sauravguptadx/4-Bit-PC-Proteus/4-Bit PC/Report Document.pdf

Bangladesh University of Engineering and Technology

Course No: CSE 404

Course Title: Digital System Design Sessional

A Report on 4-bit PC

Date of Submission: August 4, 2018

Submitted By:

Tahrina Tasnim Misha (1405100)

Nahiyaan Uddin (1405102)

Salsabil Arabi Shushmi (1405108)

Mirajul Islam (1405119)

Rajan Shrestha (1405121)

Saurav Gupta (1405122)

Introduction:
For 4-bit pc assignment we have to implement 25 instructions. According to our 25 instructions the 4-bit PC has
-In Port
-Program Counter(PC),
-Memory address register(MAR)
- Memory
- Memory Data Register(MDR)
- Instruction Register(IR) -Controller sequencer(CON)
- Accumulator(ACC)
- Arithmetic logic unit(ALU) -Flag
-Temp reg
-B reg
-Stack pointer(SP)
-Output reg(OUT)
-Display

The Address bus is of 8-bit
The Data is 4-bit
We need several clock cycles and maximum 11 T-cycles for an instruction. We need 40 signal pins on a whole.

Instruction set:

Instruction | Description
1. STA address | Memory[address] ← Acc
2. MOV Acc, B | Acc ← B
3. MOV B, Acc | B ← Acc
4. ADC B | Acc ← Acc + B + Carry
5. SUB B | Acc ← Acc - B
6. SBB address | Acc ← Acc - Memory[address] - Carry
7. SBB Immediate Acc ← Acc - Immediate - Carry
8. IN | Acc ← Input_port
9. OUT | Output _port ← Acc
10. PUSH | Pushes the content of the Accumulator to the Stack
11. POP | Pops off top element of stack to Accumulator
12. AND B | Acc ← Acc.B
13. OR address | Acc ← Acc | Memory[address]
14. OR Immediate Acc ← Acc | Immediate
15. XOR address | Acc ← Acc Memory[address]
16. CMP B | Accumulator will be unchanged. Set flags according to ( Acc - B )
17. SHL | Acc ← Acc << 1, Carry ← Acc [MSB], Acc [LSB] ← 0
18. ROR | Acc ← Acc >> 1, Carry ← Acc [LSB], Acc [MSB] ← Acc [LSB]
19. JMP address | Jumps to the address
20. JNC address | Jumps to the address if Carry flag is not set
21. JG address | Jump if greater
22. JL address | Jump if less
23. CMC | Complements the Carry flag
24. CLC | Clears the Carry flag
25. HLT | Halts execution

Block Diagram:

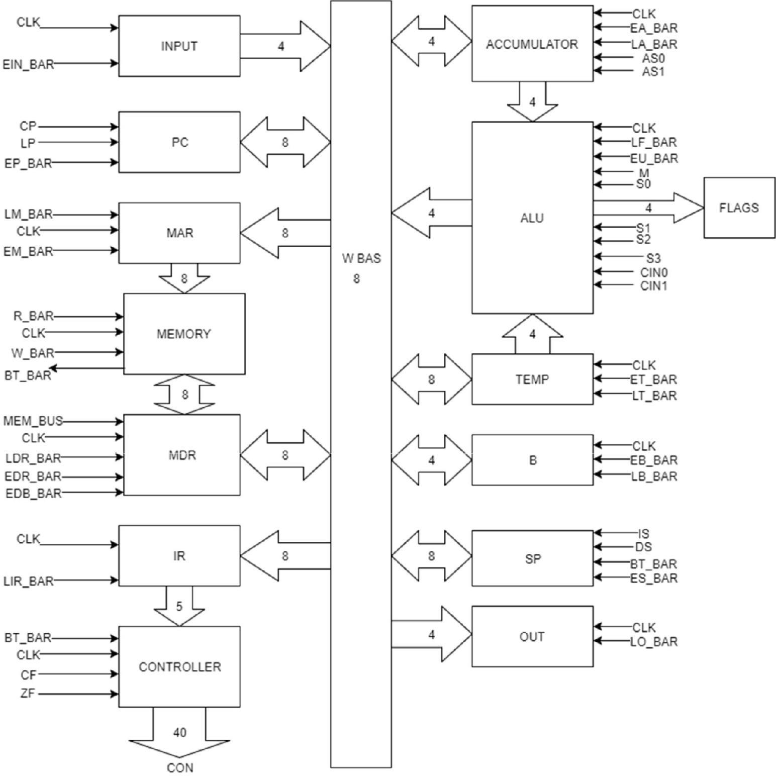
[picture p1: figure]

Fig: block diagram of 4-bit PC

## Explanation of Blocks:

Input Register:

-Control Pin: E_IN

-4 bit register
-Used to take input from user and then store it in a buffer.
-When E_IN becomes high, the output of this register is sent to bus (W0-W3).

Program Counter:

-Control Pin: CP, L_PC, E_PC

-8 bit register
-Contains the address pointer value of the current instruction.
-After each instruction cycle it points to the next instruction in memory.
-For jump we need to load address to PC. This is also done by interacting with bus (W0-W7).
- The L_PC control pin is used to load the address of the instruction to PC.
- PC register passes its output to the bus, when E_PC is high.
-CP control pin is used to increment the PC to fetch the next instruction.

Memory Address Register:

-Control Pin: L_Mem

-8-bit register
-It takes 8-bit address as input from PC
-When L_Mem is high, address is loaded to MAR through W-bus.

9

Memory:

-Control Pin: W, R
Memory has two parts: RAM and Boot Loader.

RAM:

-RAM has following input lines, Mem0-Mem7, these lines connect RAM and MAR. These lines are used to provide address to RAM. And, bidirectional data line, RM0-RM7 -These lines connect MDR and RAM, using these lines either data is fed into RAM using the W signal, or Data is read from RAM using the R signal.

-To write content to RAM at a particular address, we must point at the interested address of RAM using MAR, we provide data in RM0-RM7 lines via MDR, then we control W signal to write the data.
-To read content from RAM at a particular address, we point that address using MAR, then we control the R signal to read content from RAM, later on this data is sent to MDR.

Boot loader:

-Boot loader resides inside the MEMORY module. It is responsible for loading program data from a ROM to RAM during boot period.
-Boot loader is consisted of two ROMs, and two counters. One of the ROMs contains the instructions and data and a special sentinel value FF, which is used to terminate the boot-loading process.
-The second ROM contains control words to drive the boot-loading process.
-Using one counter, we provide same address to both the program ROM and RAM, so that content in ROM at a particular address can be sent to that exact address in RAM. -Using the second counter, we drive the boot control ROM.

10

Memory Data Register:

The Control Pin: L_MDR_RAM, L_MDR_BUS, E_MDR _RAM, E_MDR _BUS.

-8-bit register
- RM0-RM7 is used to read from or write into memory through data line.
-When L_MDR_RAM is HIGH, data is loaded to MDR from RAM. This is used to read data from RAM.
-When L_MDR_BUS is HIGH, data is loaded to MDR from the BUS.
-When E_MDR_BUS is HIGH, data from the MDR is sent to BUS via W0-W7. -When E_MDR _RAM is HIGH, data from the MDR is sent to RAM via RM0-RM7.

Instruction Register:

Control Pin: L_IR

-When L_IR is HIGH, IR can load content from MDR via W0-W7 line.
-Instruction Register is an 8-bit register.
-During Fetch cycle, IR is loaded with 8-bit op-code of an instruction through W-bus (W0-W7 line) from MDR. Our 4-bit PC can execute 25 Instructions, so we only need 5 bits. IR register then sends the least significant 5 bits of the op-code to Control register using the CON0-C0N4 line.

Controller-Sequencer:

Generates the control word for each micro instructions. It has two kinds of ROMs. They are:
1. Address ROM
2. Control ROMs

-The address ROM contains a list of starting address of the execution cycle of each macro instructions.
-We need only 5 bits because our 4-bit PC can execute 25 macro-instruction, so we need only 5 bits (2^5=32) to index all the macro instructions.
-According to these 5 op-code bits, starting address of the execution cycle of a particular micro instruction is generated.
-Our control ROMs consist of five cascading ROMs, because our control word is 40-bit length. The outputs of these ROMs are our control word for a particular micro instruction.
-The zero index refers to the first microinstruction of fetch cycle and corresponding control word is generated by the control ROMs.

-The control word for second, third and fourth micro instructions of fetch cycle are generated in the same way.
-When LOAD signal is active, our address ROM loads op-code from Instruction Register. On the next clock cycle, the counter starts counting from the address generated by address ROM which refers to the index first micro instruction of the execution cycle of that macro operation.
-We need to mark the end of a macro instruction. At the last micro instruction of each macro operation, we set a special RESET signal to 1. When this RESET signal is active, the counter resets to 0 which refers to the index of the first micro instruction of fetch cycle and the process continues.

Accumulator Register:

Control Pin: E_ACC, L_ACC, AS0, AS1

-4-bit register that can load data from bus or send data to bus using W0-W3 line. It also passes data to Arithmetic Logic Unit (ALU) through A0-A3 line to perform different arithmetic and logic operations.
-When E_ACC is HIGH, the data of Accumulator register is sent to W-bus.
-When L_ACC is low, Accumulator register loads data from W-bus.
-AS0 and AS1 are used to shift the content of Accumulator register.
-When both AS0 and AS1 are high, Accumulator contents are unchanged. This is why we need to set these two control pins every time we need to load data into accumulator. -When AS0 is high and AS1 is low, Accumulator contents are shifted right.
- When AS0 is low and AS1 is high, Accumulator contents are shifted left.
-CACC is used to store the CARRY.

Arithmetic Logic Unit:

Control Pin: L_FLAG, E_ALU, M, S0, S1, S2, S3, CIN0, CIN1

ALU takes data from Accumulator register through A0-A3 line and from Temp Register through T0-T3 line and performs various arithmetic and logic operations.

ALU uses five control bits M, S0, S1, S2 and S3 to do various operations on word A and word B.
Data inputs for ALU come from Accumulator register (ACC) and Temp register (TEMP).

The function table is given in the next page.

-Arithmetic operations like ADD, ADC, SUB, SBB require us to put different values in CN bit of the ALU.
-In an ADD operation, we need to put 0 in CN pin.
-In an ADC operation, we need to put carry flag in CN pin.
-In a SUB operation we need to put 1 in CN.
-In a SBB operation we need to put the invert of carry flag in CN pin.
-To ensure these, we introduce two pins CIN0 and CIN1 to control the content of CN bit of ALU.

The combination is given below:

CIN1 | CIN0 | CN | Operation
0 | 0 | 0 | ADD
0 | 1 | Carry Flag (CF) | ADC
1 | 0 | 1 | SUB
1 | 1 | Invert of Carry Flag (CF_BAR) | SBB

-We store the carry flag (CF), zero flag (ZF), sign flag (SF) and overflow flag (OF) in a register.
-Carry, sign and zero flag can be found from ALU.
-For overflow flag (OF) we use a simple logic which is, when two positive numbers are added and the result is negative or when two negative numbers are added and the result is positive, overflow occurs.

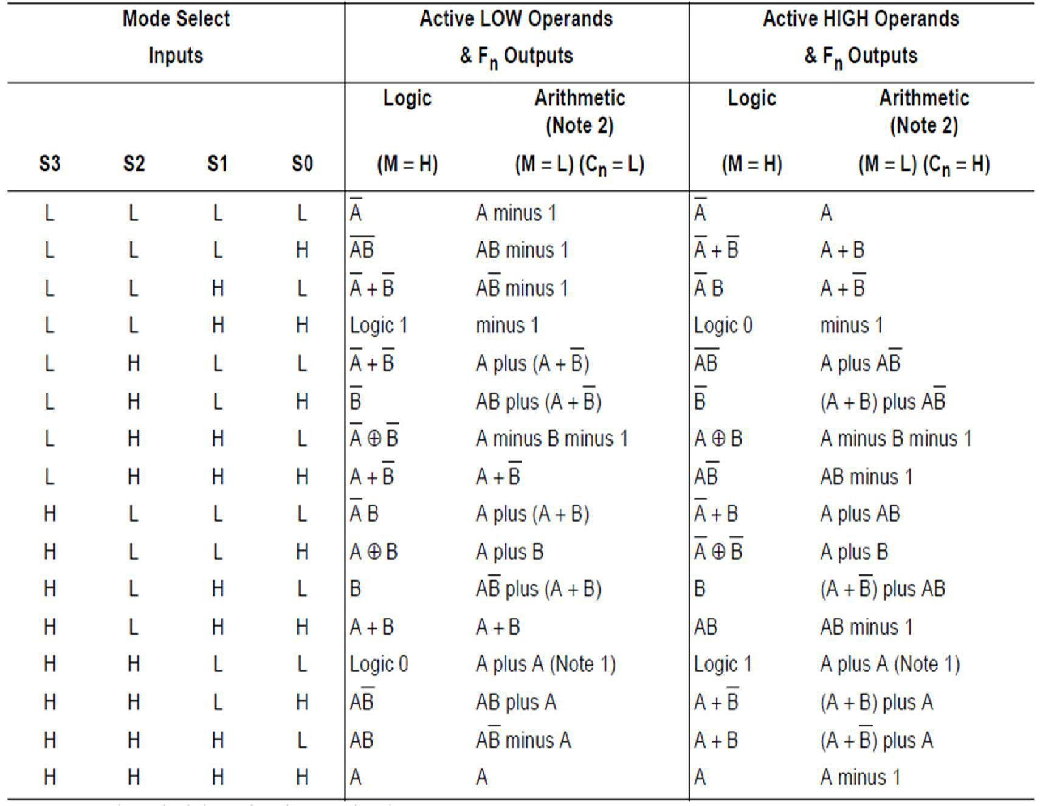
[picture p2: figure]

Temporary Register:

Control Pin: L_TEMP

-8-bit register to store 4-bit data for our instructions
-This register can load data from W-bus using W0-W3 line.
-It sends data to Arithmetic Logic Unit (ALU) through T0-T3 line continuously to perform different arithmetic and logic operations.
-When L_TEMP is HIGH, Temp register loads data from W-bus.

B Register:

Associated Control Pin: L_B, E_B

- 4-bit register that can load data from W-bus or send data to W-bus using W0-W3 line. -When E_B is HIGH, the data of B register is sent to W-bus.
-When L_B is HIGH, B register loads data from W-bus.

Stack Pointer:

Control Pin: E_SP, INC_SP, DEC_SP

-It is an 8-bit register that stores the address of the last program request in a stack. -Initially, the Stack Pointer points to FF-the last memory location.
-For push operation, SP is first decremented and then loaded to MAR so that data can be written in that location.
-If a POP operation is done, SP is loaded to MAR so that data in that address can be read and after that value of SP is incremented.

-When E_SP is HIGH, the contents of Stack Pointer (SP) is sent to bus through W0-W7 line.
-When INC_SP is HIGH, the value of SP is incremented.
-When DEC_SP is HIGH, the value of SP is decremented.

Output Register:

-Control Pin: L_OUT

-It is 4-bit register that can load data from W-bus through W0-W3 line to show the result of different operations.

When L_OUT is HIGH, OUT register loads data from W-bus.

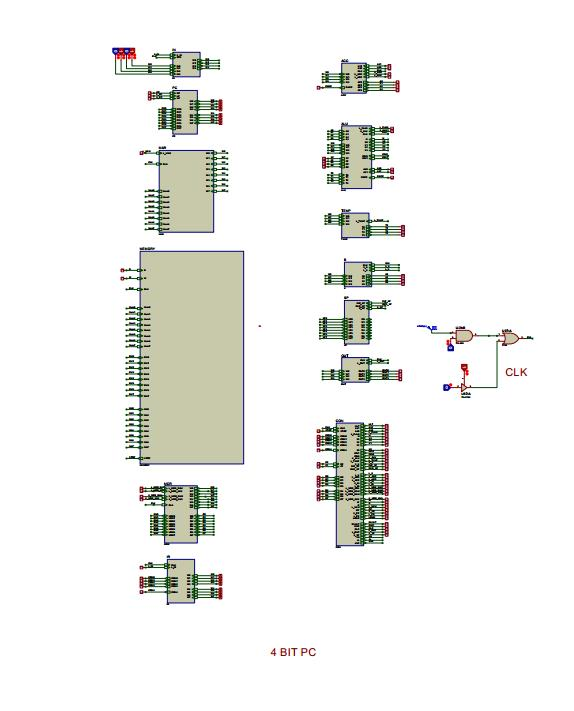
[picture p3: page 12]

Circuit Diagrams:

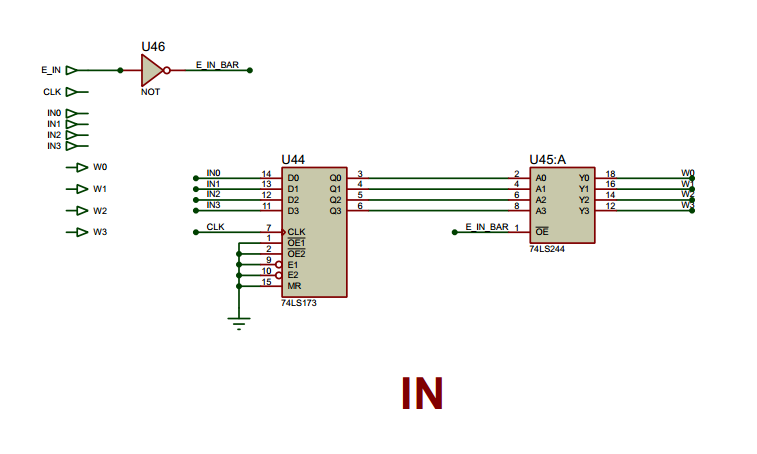
[picture p4: figure]

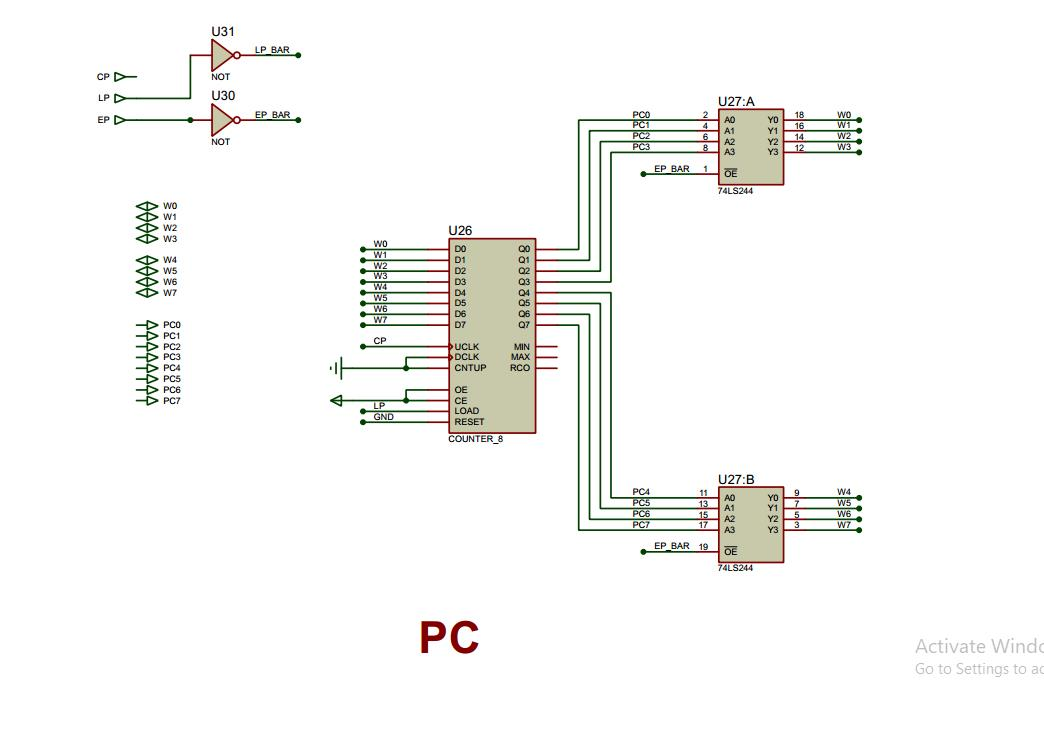
[picture p5: figure]

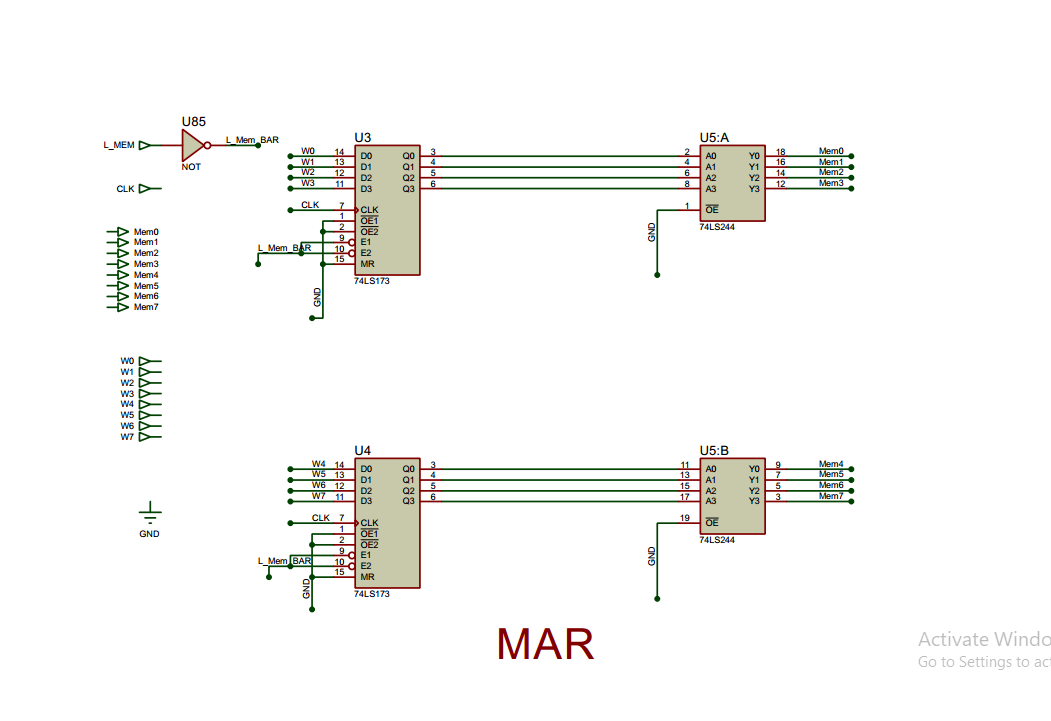
[picture p6: figure]

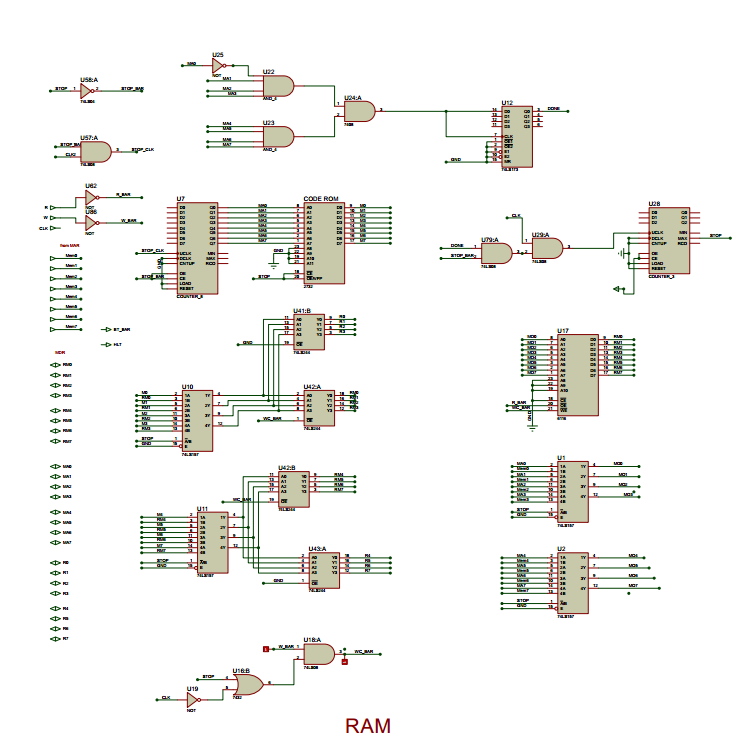
[picture p7: figure]

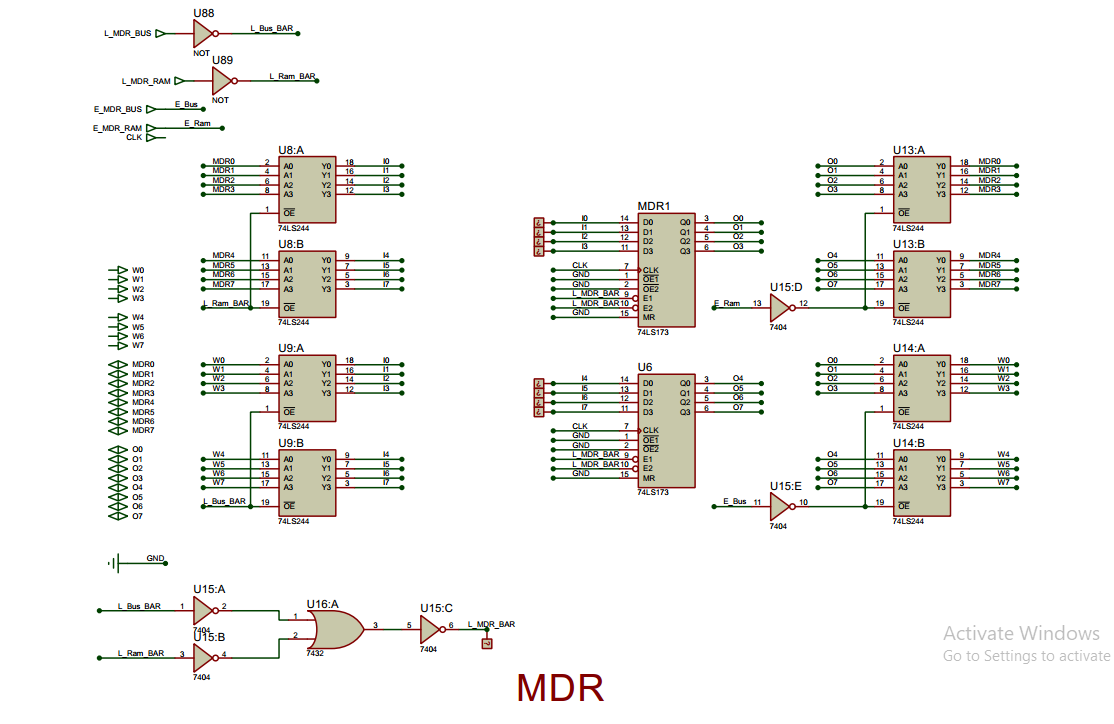
[picture p8: figure]

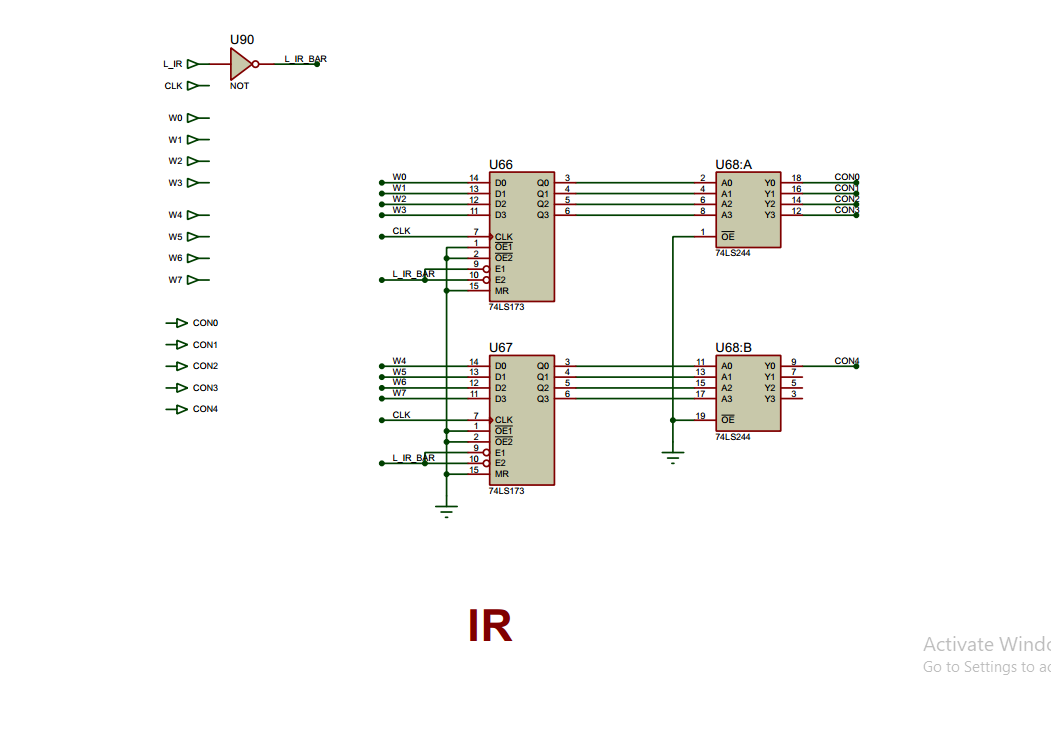
[picture p9: figure]

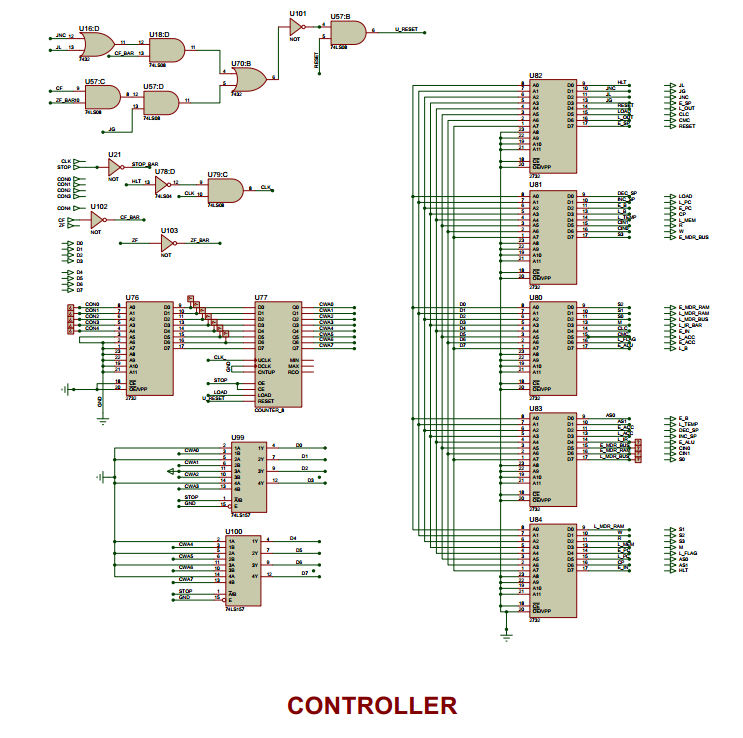
[picture p10: figure]

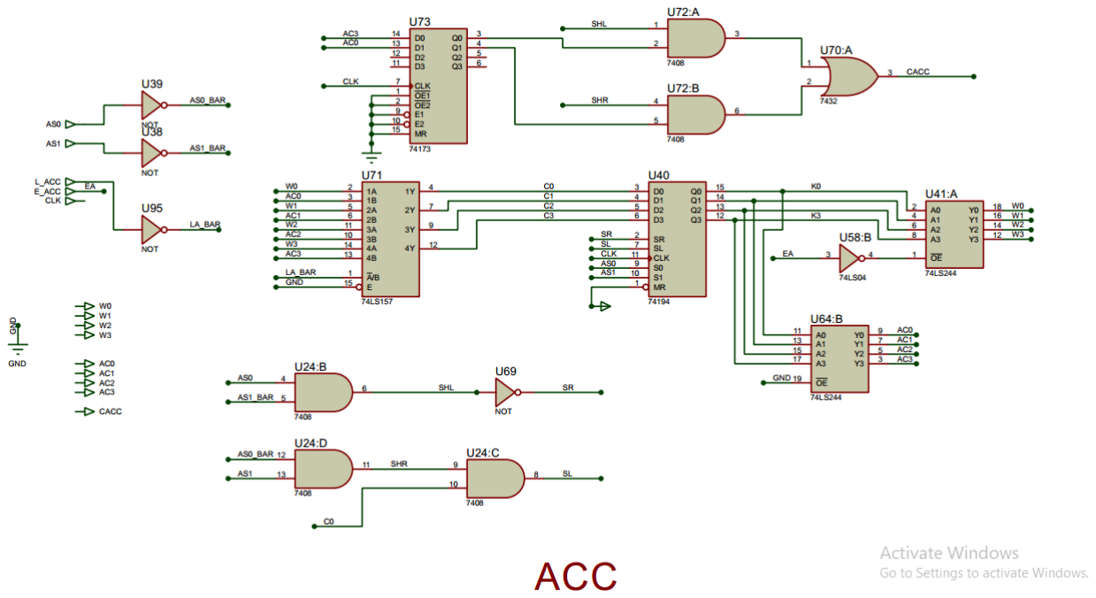
[picture p11: figure]

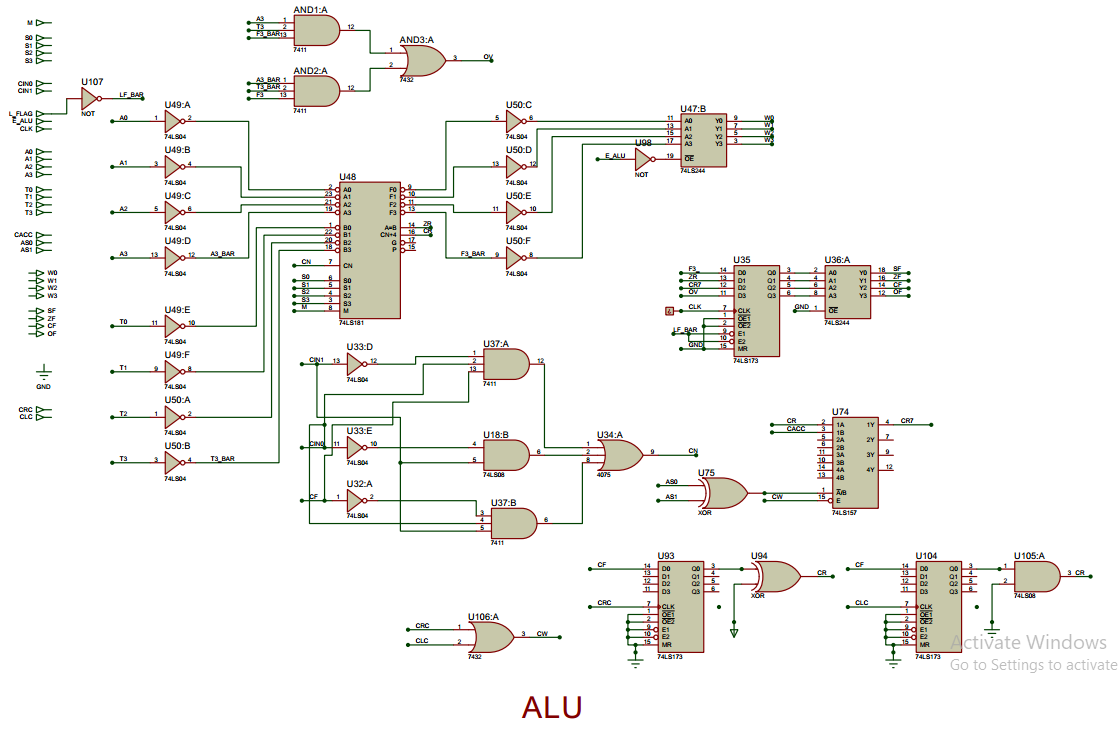
[picture p12: figure]

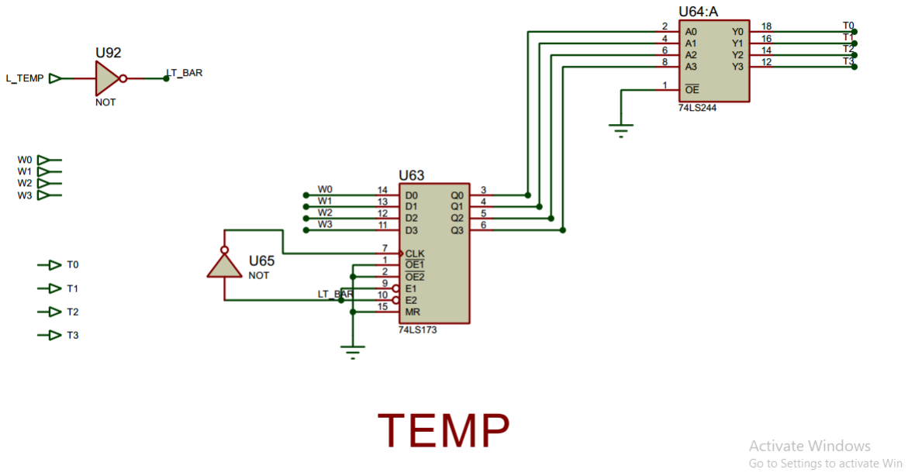
[picture p13: figure]

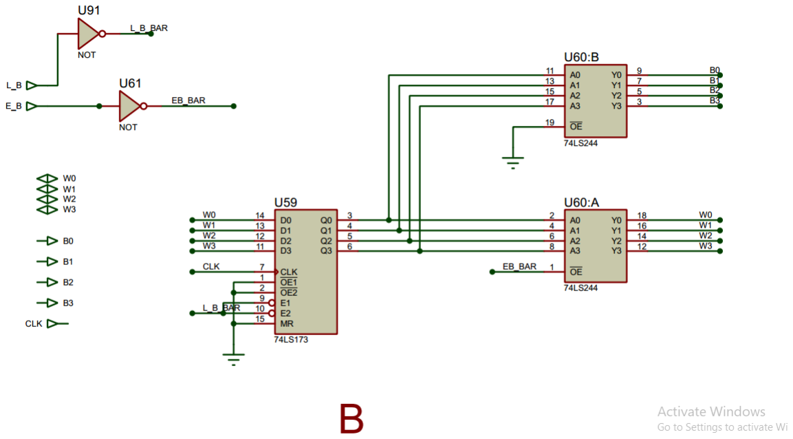
[picture p14: figure]

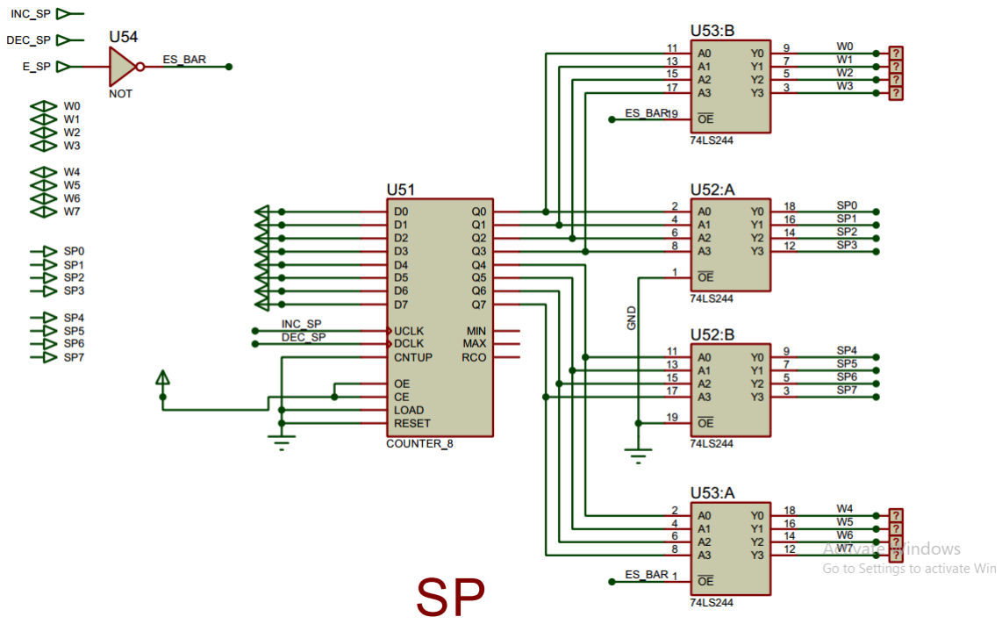
[picture p15: figure]

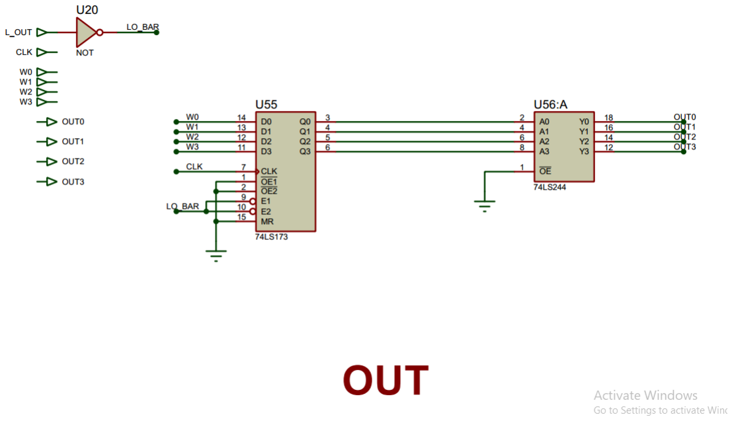
[picture p16: figure]

Explanation of all instructions:

Description | Total T-States | T-State | Micro-Operation | Active | CR O M 0 | CR O M 1 | CR O M 2 | CR O M3 | CR O M 4
Fetch | 4 | T1 | MAR ← PC | L_MEM, E_PC | 10 | 18 | ff | df | 0
| | T2 | PC← PC+1, MDR ← RAM[MAR] | CP, L_MDR_RAM, R, | 10 | 18 | ff | ce | 98
| | T3 | IR ← MDR | E_MDR_BUS, L_IR | 10 | 18 | ff | 9b | c8
| | T4 | LOAD from IR | LOAD | 10 | 18 | ff | df | ca
ACC ← RAM[address] | 9 | T5 | MAR ← PC | L_MEM, E_PC | 10 | 18 | ff | df | 0
| | T6 | PC← PC+1, MDR ← RAM[MAR] | CP, L_MDR_RAM, R | 10 | 18 | ff | ce | 98
| | T7 | MAR ← MDR | L_MEM, E_MDR_BUS, | 10 | 18 | ff | db | 8
| | T8 | MDR ← RAM[MAR] | L_MDR_RAM, R | 10 | 18 | ff | ce | 88
| | T9 | ACC ← MDR | L_ACC, E_MDR_BUS, AS0, AS1, RESET | 70 | 18 | fe | db | c9
Halts execution | 5 | T5 | HALT | HLT | 90 | 18 | ff | df | c8
ACC ← input_port | 5 | T5 | ACC ← input_port | L_ACC, AS0, AS1, E_IN, RESET | 70 | 18 | fe | 5f | c9
RAM[address] ← ACC | 12 | T5 | MAR ← PC | L_MEM, E_PC | 10 | 18 | ff | df | 0
| | T6 | PC← PC+1, MDR ← RAM[MAR] | CP, L_MDR_RAM, R | 10 | 18 | ff | ce | 98
| | T7 | MAR ← MDR | L_MEM, E_MDR_BUS, | 10 | 18 | ff | db | 8
| | T8 | MDR ← ACC | L_MDR_RAM, E_ACC, E_MDR_BUS, | 10 | 18 | fd | ef | 88
| | T9 | RAM[MAR] ← MDR | E_MDR_RAM, | 10 | 18 | ff | d7 | 88
| | T10 | | W, E_MDR_RAM, | 10 | 18 | ff | d5 | 88
| | T11 | | E_MDR_RAM, | 10 | 18 | ff | d7 | 88
| | T12 | | R, RESET, | 10 | 18 | ff | de | 89
output_port ← ACC | 5 | T5 | output_port ← ACC | L_OUT, E_ACC, RESET | 10 | 18 | ed | df | c9
B ← ACC | 5 | T5 | B ← ACC | L_B, E_ACC, RESET | 10 | 18 | f9 | df | c9
ACC ← B | 5 | T5 | ACC ← B | L_ACC, AS0, AS1, E_B, RESET | 70 | 18 | f6 | df | c9
ACC ← immediate | 7 | T5 | MAR ← PC | L_MEM, E_PC, | 10 | 18 | ff | df | 0
| | T6 | PC← PC+1, MDR ← RAM[MAR] | CP, L_MDR_RAM, R, | 10 | 18 | ff | ce | 98
| | T7 | ACC ← MDR | L_ACC, AS0, AS1, E_MDR_BUS, RESET | 70 | 18 | fe | db | c9
NOP | 5 | T5 | NOP | RESET | 10 | 18 | ff | df | c9
Jump to the address | 8 | T5 | MAR ← PC | L_MEM, E_PC, | 10 | 18 | ff | df | 0
| | T6 | PC← PC+1, MDR ← RAM[MAR] | CP, L_MDR_RAM, R, | 10 | 18 | ff | ce | 98
| | T7 | PC ← MDR | LP, E_MDR_BUS | 10 | 18 | ff | db | cc
T8 | | CP, LP, RESET | 10 | 18 | ff | df | dd
ACC ← ACC + B | 7 | T5 | TEMP ← B | L_TEMP, E_B, S3, S0 | 14 | 98 | b7 | df | c8
| | T6 | ACC ← ACC + TEMP | S3, S0 | 14 | 98 | ff | df | c8

| | T7 | | L_ACC, AS0, AS1, E_ALU, S3, S0, L_FLAG, RESET | 64 | 90 | fe | df | c9
ACC ← ACC + B + C | 7 | T5 | TEMP ← B | L_TEMP, E_B, S3, S0, CIN0 | 14 | b8 | b7 | df | c8
| | T6 | ACC ← ACC + TEMP + C | S3, S0, CIN0 | 14 | b8 | ff | df | c8
| | T7 | | L_ACC, AS0, AS1, E_ALU, S3, S0, CIN0, L_FLAG, RESET | 64 | b0 | fe | df | c9
ACC ← ACC -B | 7 | T5 | TEMP ← B | L_TEMP, E_B, S2, S1, CIN1 | 13 | 58 | b7 | df | c8
| | T6 | ACC ← ACC - TEMP | S2, S1, CIN1 | 13 | 58 | ff | df | c8
| | T7 | | L_ACC, AS0, AS1, E_ALU, S2, S1, CIN1, L_FLAG, RESET | 63 | 50 | fe | df | c9
ACC ← ACC - B - BO | 7 | T5 | TEMP ← B | L_TEMP, E_B, S2, S1, CIN1, CIN0 | 13 | 78 | b7 | df | c8
| | T6 | ACC ← ACC - TEMP - BO | S2, S1, CIN1, CIN0 | 13 | 78 | ff | df | c8
| | T7 | | L_ACC, AS0, AS1, E_ALU, S2, S1, CIN1, CIN0, L_FLAG, RESET | 63 | 70 | fe | df | c9
ACC ← ACC + immediate | 9 | T5 | MAR ← PC | L_MEM, E_PC, | 10 | 18 | ff | df | 0
| | T6 | PC← PC+1, MDR ← RAM[MAR] | CP, L_MDR_RAM, R, | 10 | 18 | ff | ce | 98
| | T7 | TEMP ← MDR | L_TEMP, E_MDR_BUS, S3, S0 | 14 | 98 | bf | db | c8
| | T8 | ACC ← ACC + TEMP | S3, S0 | 14 | 98 | ff | df | c8
| | T9 | | L_ACC, AS0, AS1, E_ALU, S3, S0, L_FLAG, RESET | 64 | 90 | fe | df | c9
ACC ← ACC -RAM[address] | 11 | T5 | MAR ← PC | L_MEM, E_PC, | 10 | 18 | ff | df | 0
| | T6 | PC← PC+1, MDR ← RAM[MAR] | CP, L_MDR_RAM, R, | 10 | 18 | ff | ce | 98
| | T7 | MAR ← MDR | L_MEM, E_MDR_BUS, | 10 | 18 | ff | db | 8
| | T8 | MDR ← RAM[MAR] | L_MDR_RAM, R, | 10 | 18 | ff | ce | 88
| | T9 | TEMP ← MDR | L_TEMP, E_MDR_BUS, S2, S1, CIN1 | 13 | 58 | bf | db | c8
| | T10 | ACC ← ACC - TEMP | S2, S1, CIN1 | 13 | 58 | ff | df | c8
| | T11 | | L_ACC, AS0, AS1, E_ALU, S2, S1, CIN1, L_FLAG, RESET | 63 | 50 | fe | df | c9
ACC -B | 7 | T5 | TEMP ← B | L_TEMP, E_B, S2, S1, CIN1 | 13 | 58 | b7 | df | c8
| | T6 | ACC - TEMP | S2, S1, CIN1 | 13 | 58 | ff | df | c8
| | T7 | | S2, S1, CIN1, L_FLAG, RESET | 3 | 58 | ff | df | c9
ACC & B | 6 | T5 | TEMP ← B | L_TEMP, E_B | 10 | 18 | b7 | df | c8
| | T6 | ACC & TEMP | L_FLAG, M, S3, S2, S1, RESET | f | 18 | ff | df | c9
ACC ← ACC & B | 6 | T5 | TEMP ← B | L_TEMP, E_B | 10 | 18 | b7 | df | c8
| | T6 | ACC ← ACC & TEMP | L_ACC, AS0, AS1, E_ALU, M, S3, S2, S1, RESET | 7f | 10 | fe | df | c9
ACC ← ACC ⊕ immediate | 8 | T5 | MAR ← PC | L_MEM, E_PC, | 10 | 18 | ff | df | 0
| | T6 | PC← PC+1, MDR ← RAM[MAR] | CP, L_MDR_RAM, R, | 10 | 18 | ff | ce | 98
| | T7 | TEMP ← MDR | L_TEMP, E_MDR_BUS | 10 | 18 | bf | db | c8
| | T8 | ⊕ TEMP ACC ← ACC | L_ACC, AS0, AS1, E_ALU, M, S3, S0, RESET | 7c | 90 | fe | df | c9
RAM[SP] ← ACC | 10 | T5 | SP ← SP - 1, MDR ← ACC | DEC_SP, L_MDR_RAM, E_ACC, E_MDR_BUS, | 10 | 19 | fd | ef | 88
| | T6 | MAR ← SP | L_MEM, E_SP, | 10 | 18 | 7f | df | 8

| | T7 | RAM[MAR] ← MDR | E_MDR_RAM, | 10 | 18 | ff | d7 | 88
| | T8 | | W, E_MDR_RAM, | 10 | 18 | ff | d5 | 88
| | T9 | | E_MDR_RAM, | 10 | 18 | ff | d7 | 88
| | T10 | | R, RESET, | 10 | 18 | ff | de | 89
ACC ← RAM[SP] | 7 | T5 | MAR ← SP | L_MEM, E_SP, | 10 | 18 | 7f | df | 8
| | T6 | MDR ← RAM[MAR] | L_MDR_RAM, R, | 10 | 18 | ff | ce | 88
| | T7 | ACC ← MDR, SP ← SP + 1 | L_ACC, AS0, AS1, E_MDR_BUS, INC_SP, RESET | 70 | 1a | fe | db | c9
ACC ← ACC << 1 | 6 | T5 | ACC ← ACC << 1 | E_ACC | 10 | 18 | fd | df | c8
| | T6 | | L_ACC, AS0, RESET | 50 | 18 | fc | df | c9
ACC ← ACC >> 1 | 6 | T5 | ACC ← ACC >> 1 | E_ACC | 10 | 18 | fd | df | c8
T6 | | L_ACC, AS1, RESET | 30 | 18 | fc | df | c9
Jump if carry | 8 | T5 | MAR ← PC | L_MEM, E_PC, | 10 | 18 | ff | df | 0
| | T6 | PC← PC+1, MDR ← RAM[MAR] | CP, L_MDR_RAM, R, | 10 | 18 | ff | ce | 98
| | T7 | PC ← MDR | LP, E_MDR_BUS | 10 | 18 | ff | db | C c
| | T8 | | CP, LP, RESET | 10 | 18 | ff | df | D d
Jump if equal | 8 | T5 | MAR ← PC | L_MEM, E_PC, | 10 | 18 | ff | df | 0
| | T6 | PC← PC+1, MDR ← RAM[MAR] | CP, L_MDR_RAM, R, | 10 | 18 | ff | ce | 98
| | T7 | PC ← MDR | LP, E_MDR_BUS | 10 | 18 | ff | db | C c
| | T8 | | CP, LP, RESET | 10 | 18 | ff | df | D d

ICs used with count:

IC number | IC name | Number
74LS173 | 4 bit D-type register with 3 state output | 14
74LS244 | Octal 3 state buffer | 18
74LS157 | Quad 2-input Multiplexer | 5
4539 | Dual 4-input Multiplexer | 2
74LS181 | 4 bit Arithmetic Logic Unit | 1
2732 | EPROM 32K (K * 8 bit) | 8
6116 | CMOS Static RAM 16K (2K * 8 bit) | 1
COUNTER_4 | 4 bit binary up/down counter | 1
COUNTER_8 | 8 bit Binary up/down counter | 4
74LS04 | Hex Inverter | 4
74LS32 | Quad 2-input OR gate | 1
74LS08 | Quad 2-input AND gate | 2
7411 | Tri 3-input AND gate | 1
AND_4 | 4-input AND gate | 3
4075 | Tri 3-input OR gate | 1

In total, 66 ICs are used. Many of the 74LS244 (buffer) ICs are used for debugging purpose. So, in the actual circuit the number of this IC would be much less.

How to write and Execute a Program in this computer

Writing:

Writing a program for this computer can be done in two steps,
i) Writing in mnemonics form of instructions.
ii) Converting the mnemonic form to hex code. This is done by merging the hex opcode of the instruction and the hex value of the operand(address or immediate value, if exists)
Each instruction will become a hex value representing 1 or 2 bytes of information, given whether they use address or immediate value operands or not.
Next, we arrange the hex values in a BIN file line by line such that each line has a
two digit hex code( 1 byte).
Each program must be terminated with the HALT instruction which has the hex opcode F.
To denote the end of the program file, we use a special value of FF, we put this
value at the last line of the program BIN file.

A sample program:
LDA 03
MOV B,ACC
05
XOR B
OUT

Here LDA has opcode 00H, MOV B,ACC has opcode 04H, XOR B has opcode 13H, OUT has a opcode 03H.
So in Hex the program file will be:
00
02
05
13
03
We store these hex codes in a BIN file. We add, FF at the final line to denote end of FILE.

Execution:
We load this BIN file in the program ROM. When the PC starts, during the boot loader phase, each of these instructions from the program ROM is loaded into the RAM, afterwards during the fetch cycle, OP is fetched from the RAM and it is eventually sent to the instruction register and the execution phase starts

Discussion:

At first, starting the design was very difficult since we had minimum knowledge about it. Gradually by the passage of time, we could learn from mistakes and the process of designing became easier.
Designing the registers, program counter and stack pointer was easier. But, controller-sequencer and memory were quite difficult in this regards.
We faced problems while designing micro-operations for each instruction. Sometimes, we thought that particular operation could be done in single cycle, but performing them in one cycle resulted in failure. Such as, loading PC from TEMP or MDR took 2 cycles, but initially, we thought this could be done in one cycle. Writing data to an address of RAM requires 3 cycles normally. But when it is the last operation of an instruction, it takes 4 cycles since 3rd cycle of writing to RAM and RESET operation could not be done in a single cycle.
It was very difficult to understand the function of Boot_Loader. After studying more about the process of loading user program into the RAM, it became clear and we
could implement it.
We faced problem in stopping the clock when a HLT instruction is executed. Because, it was interfering with the boot loading process what we did initially. If we corrected the boot loading, then HLT was not stopping the clock. By some trial and error, we could come up with a solution.
Initially, the stack pointer was not getting set to FF rather it was getting
decremented twice and set to FE. This problem was also fixed later on.
For easier debugging, we used lots of buffers in the circuit to see the current value of different components which were not actually needed in the PC circuit.
We also used 7-Segment HEX display for observing the value of control word
and different registers.
We wrote a java code for converting the hex code for the address ROM, control ROM’s into binary file. We provided the active pins for each cycle of an instruction and our program could generate the corresponding control word from it and converted them into a binary file that could be easily used into the simulation circuit.
We also wrote a java program. It could take input a set of instructions (user program) and generate corresponding hex code of that input user program and convert them into a binary file which was loaded into the RAM during boot loading.
At the end, designing a complete PC from scratch had a great influence to all of us. It made us realize how difficult it is to design a multi-purpose PC and helped to clear our concept about so many internal issues of PC designing.

34
