sauravguptadx/4-Bit-PC-Proteus/4-Bit PC/4-BIT-FULL-CIRCUIT.pdf

PC

## ACCUMULATOR

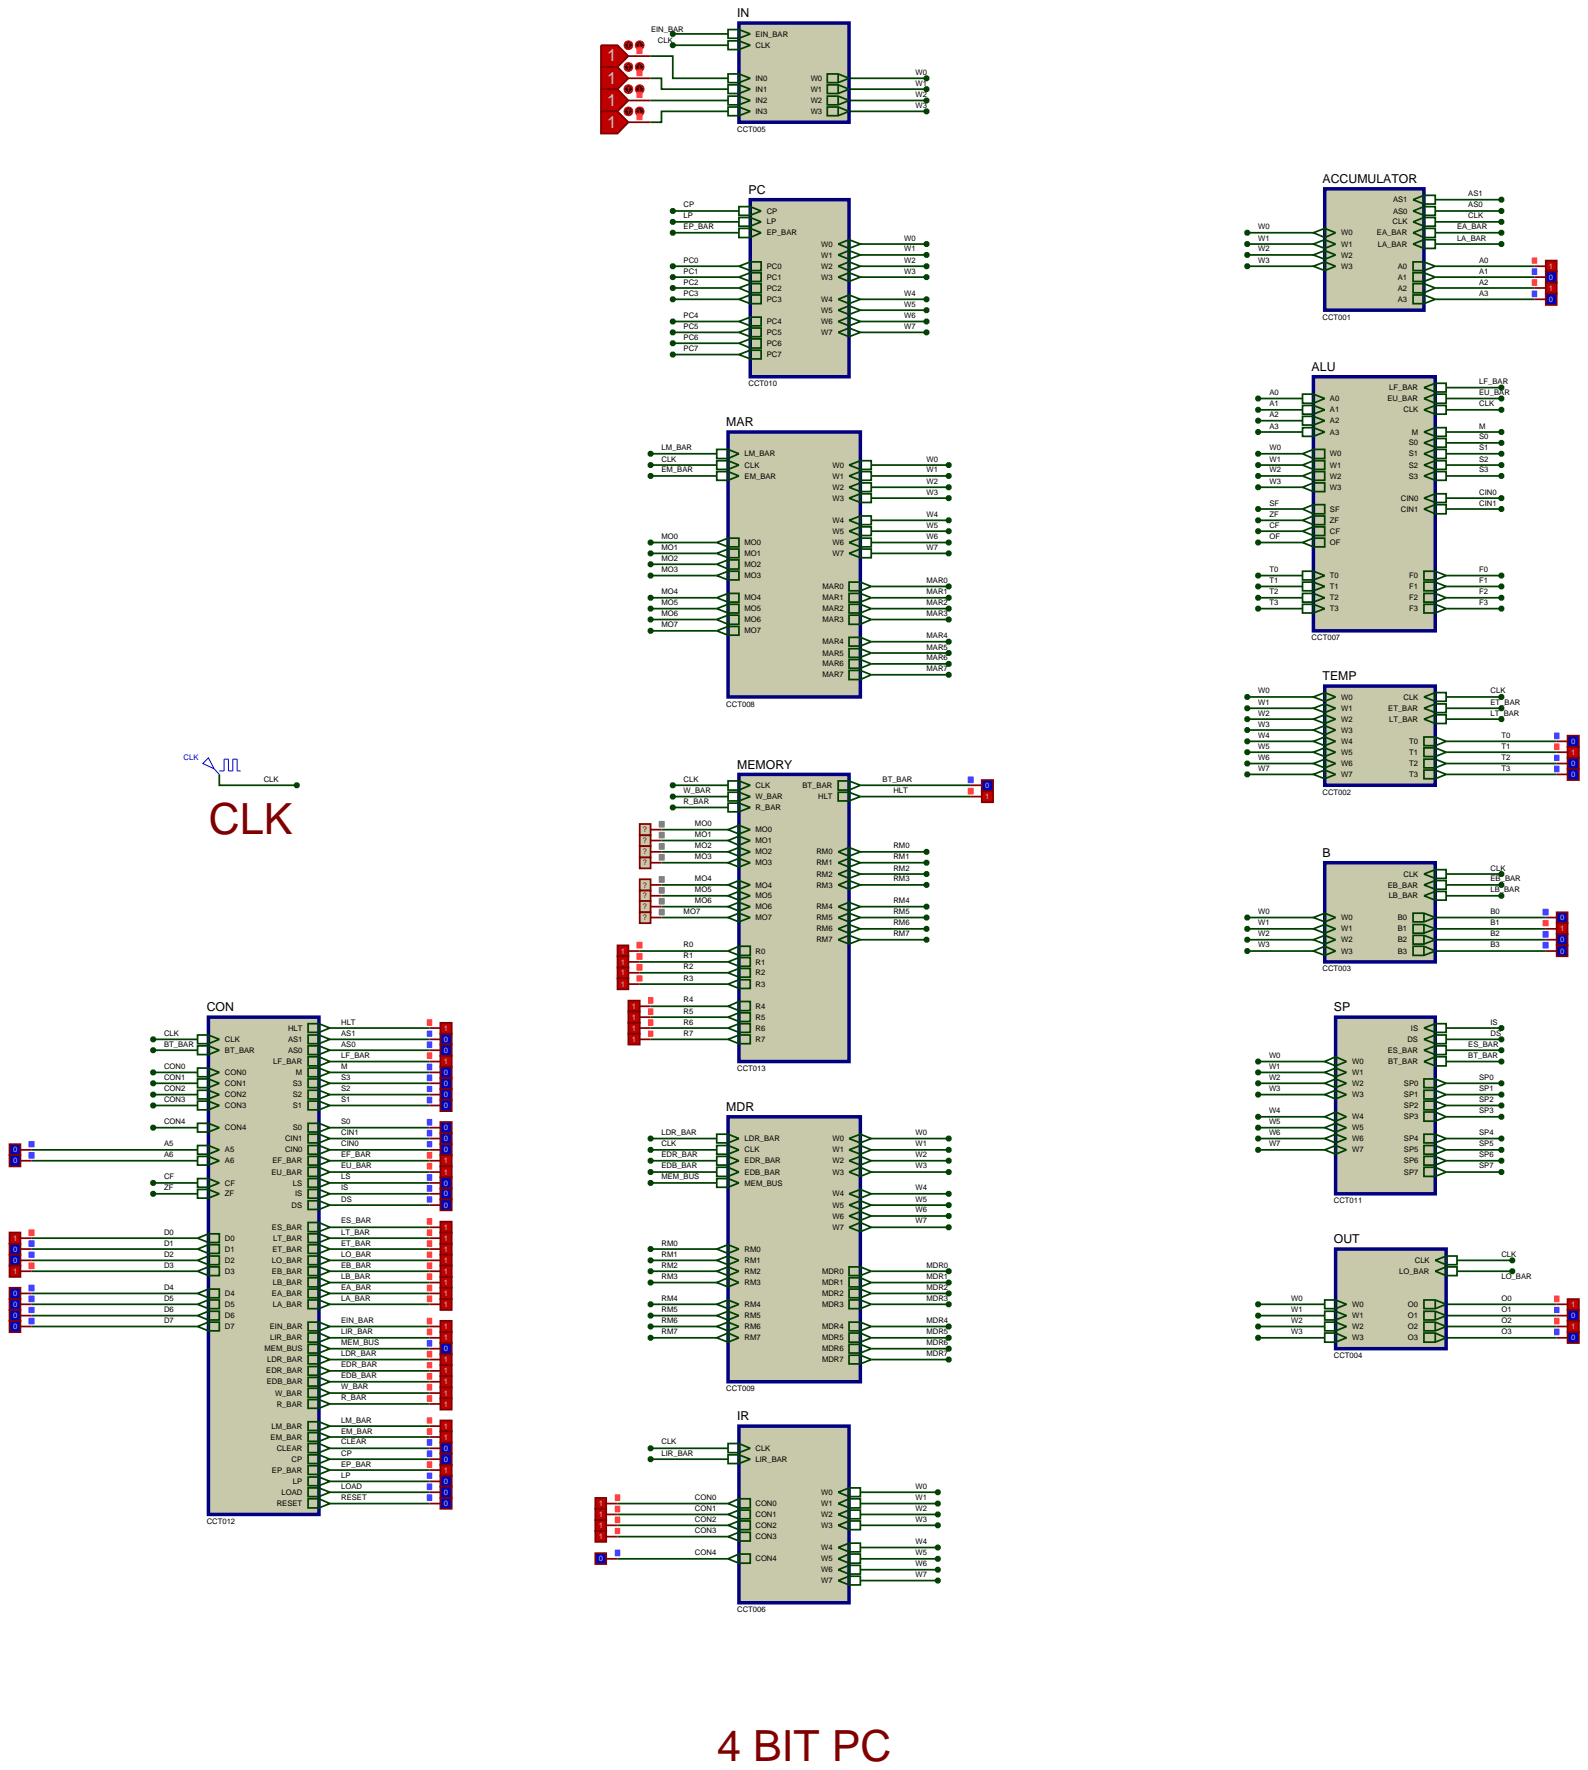
[picture p17: page 1]

U27

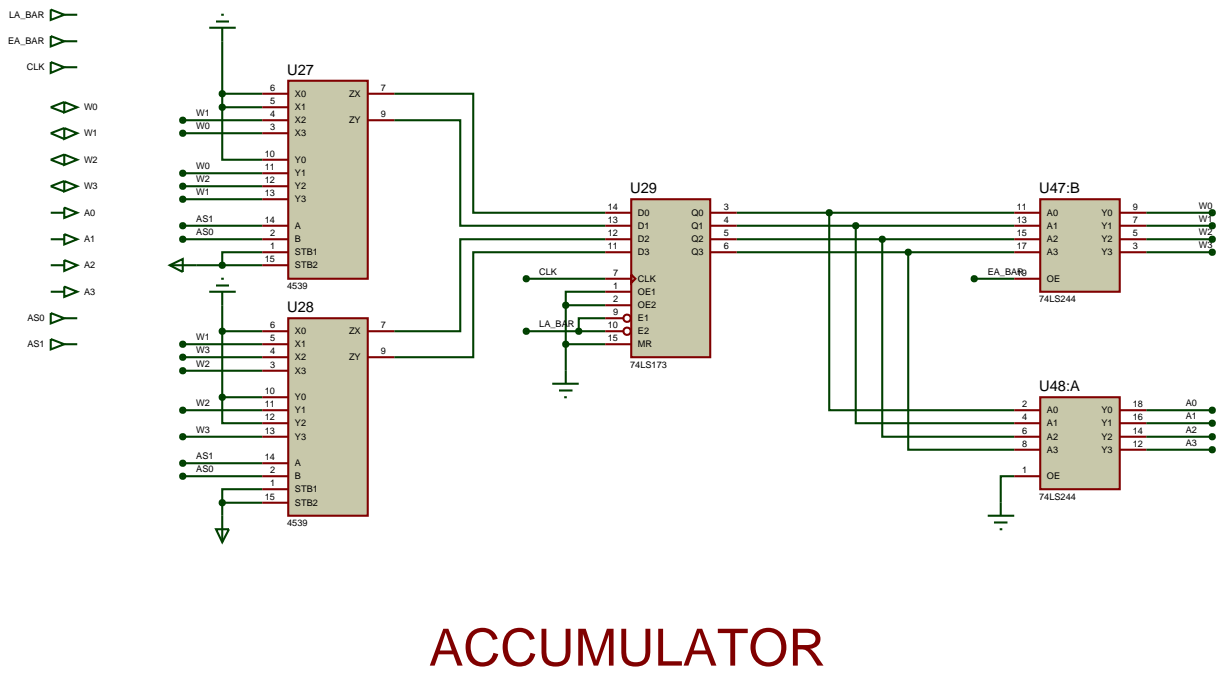
[picture p18: page 2]

U51:B

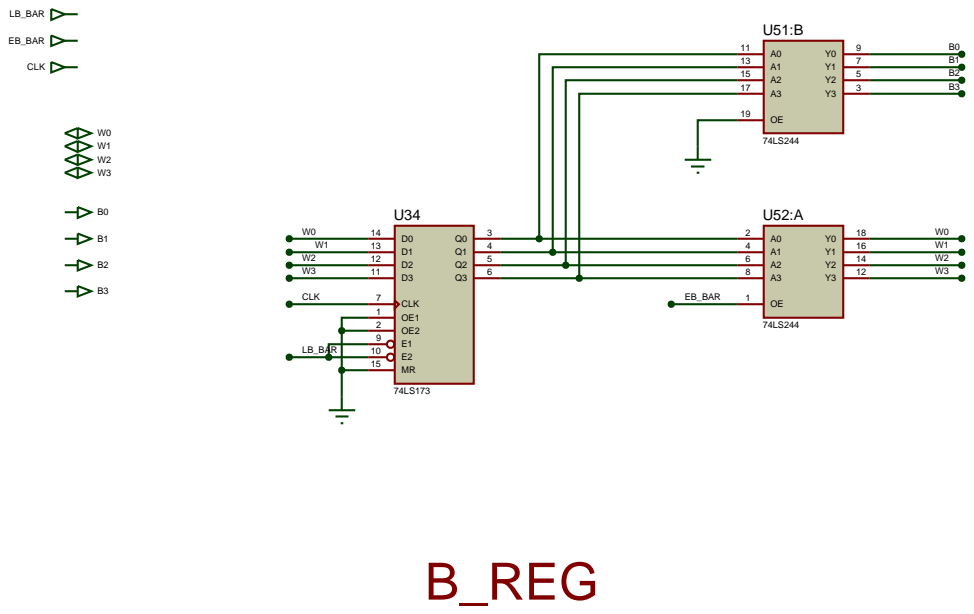
[picture p19: page 3]

A1 13
A2 15
A3 17

9 | E2 10 MR 15

U50:A

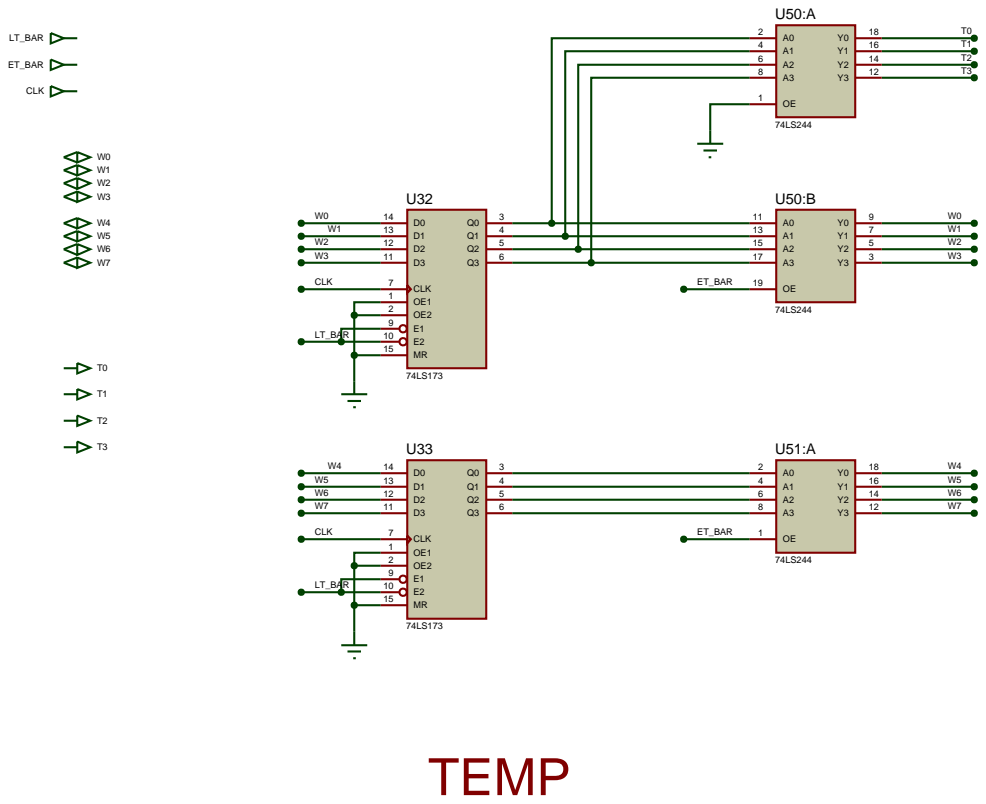
[picture p20: page 4]

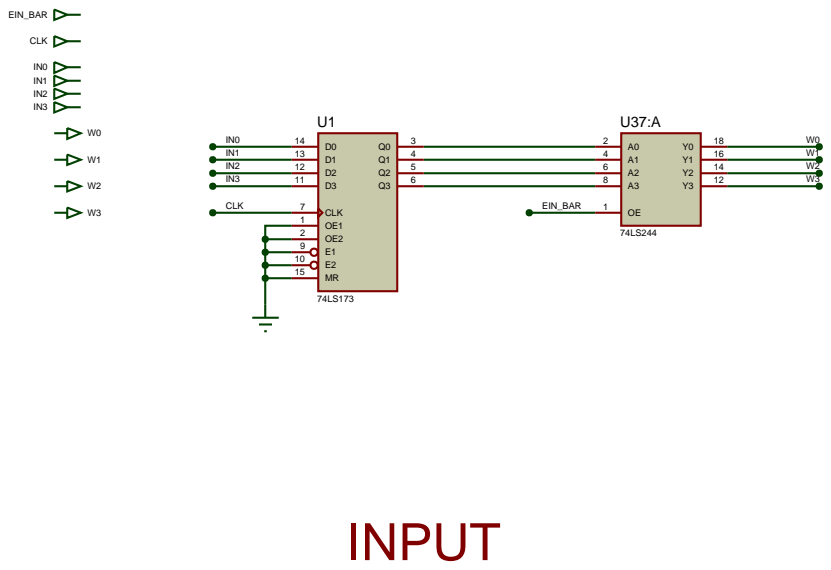
[picture p21: page 5]

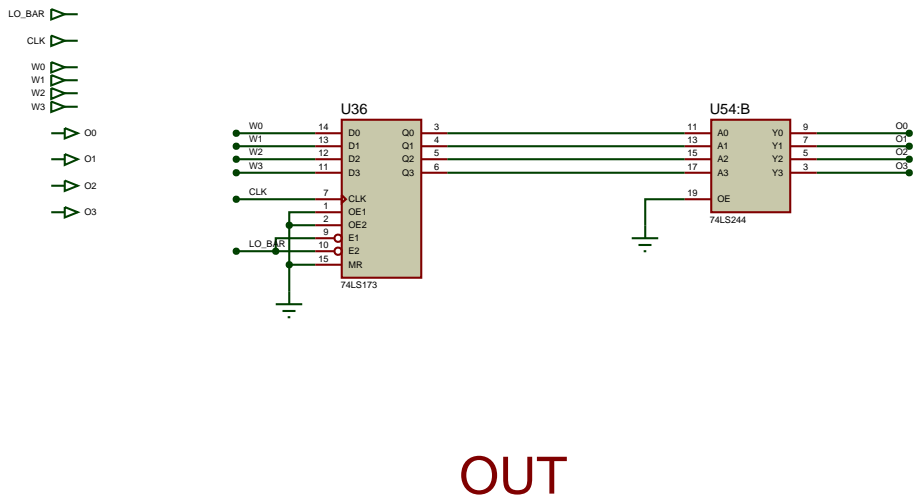
[picture p22: page 6]

9 | E2 10 MR 15

U39:B

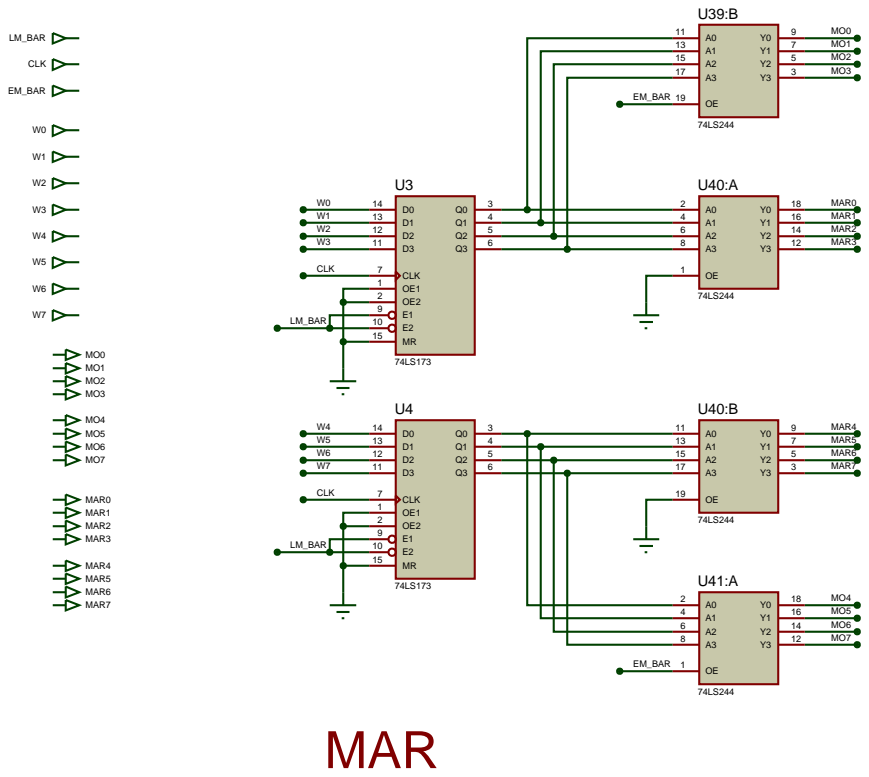
[picture p23: page 7]

U44:A

U43:B

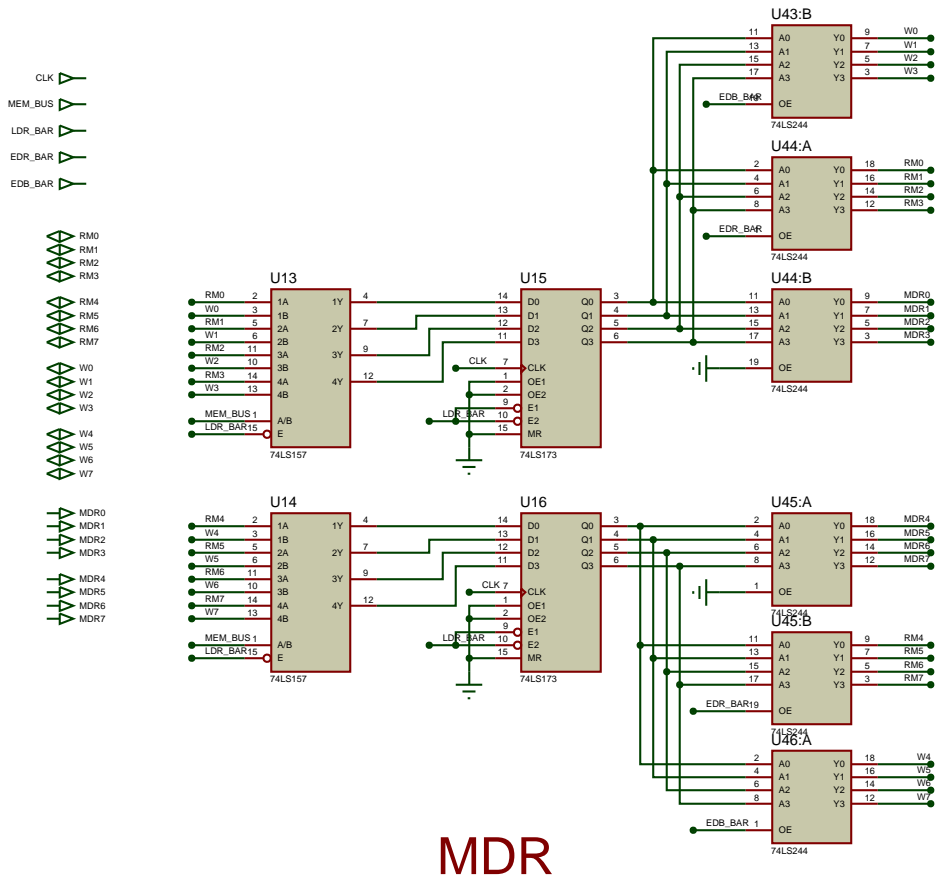
[picture p24: page 8]

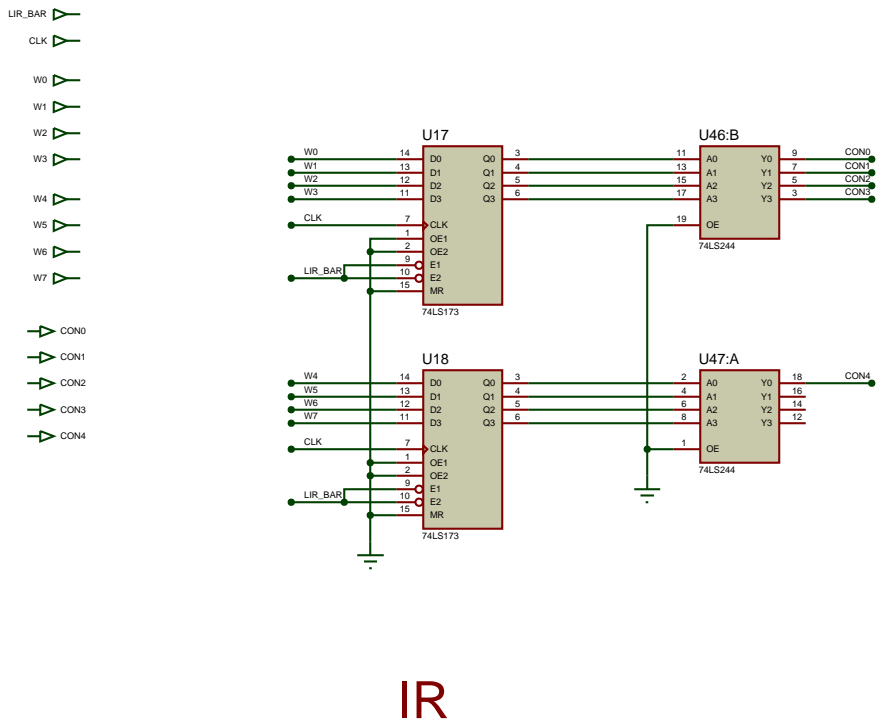
[picture p25: page 9]

U37:B

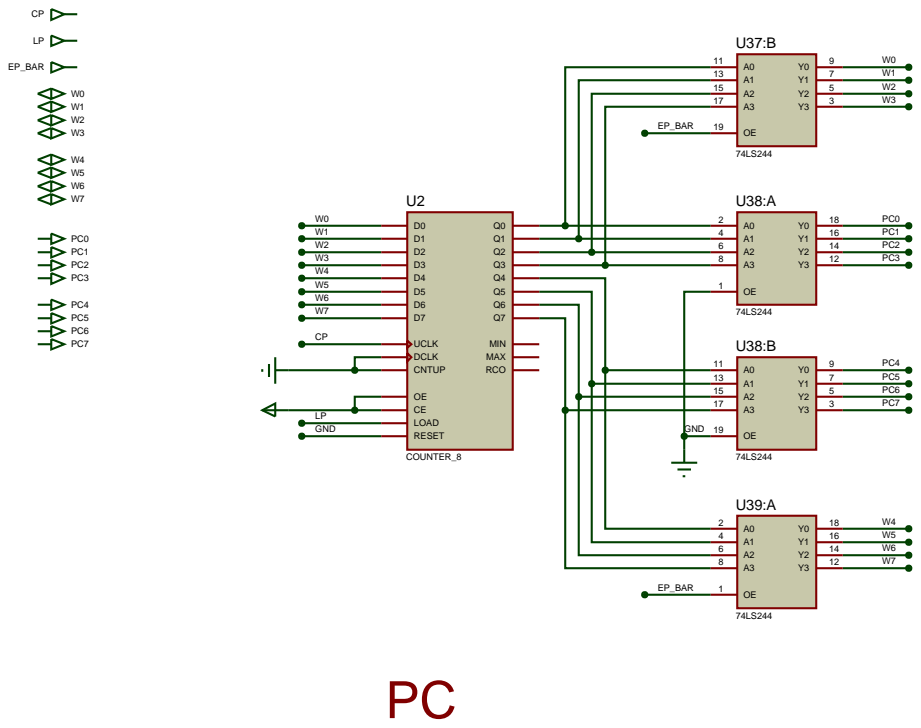
[picture p26: page 10]

A1 13
A2 15
A3 17

GND | OE 19

U52:B

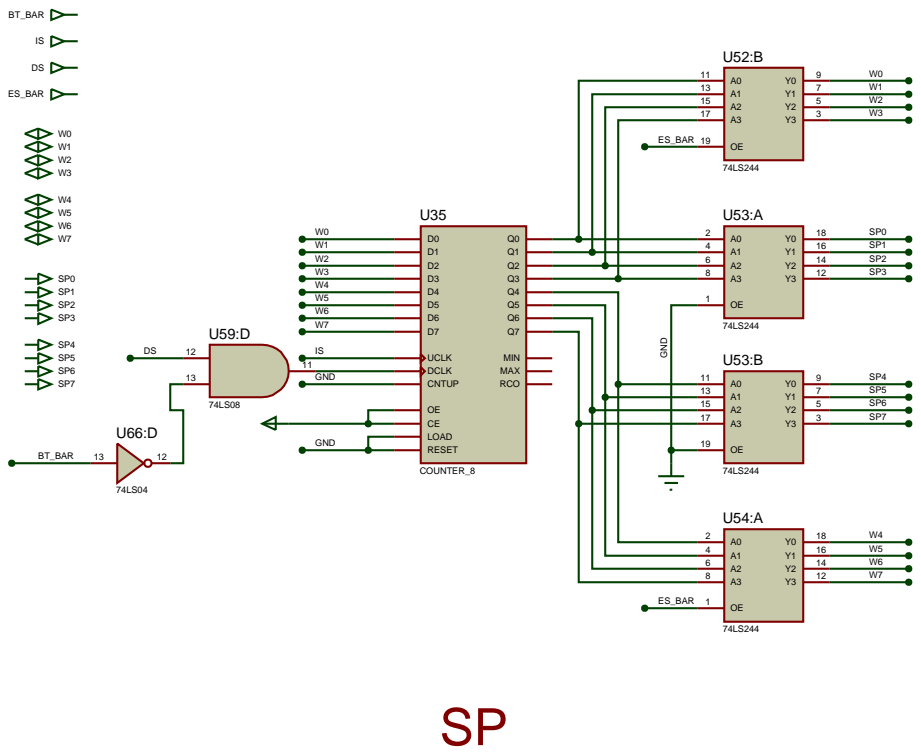
[picture p27: page 11]

A1 13
A2 15

A3 17

U48:B

U61:A

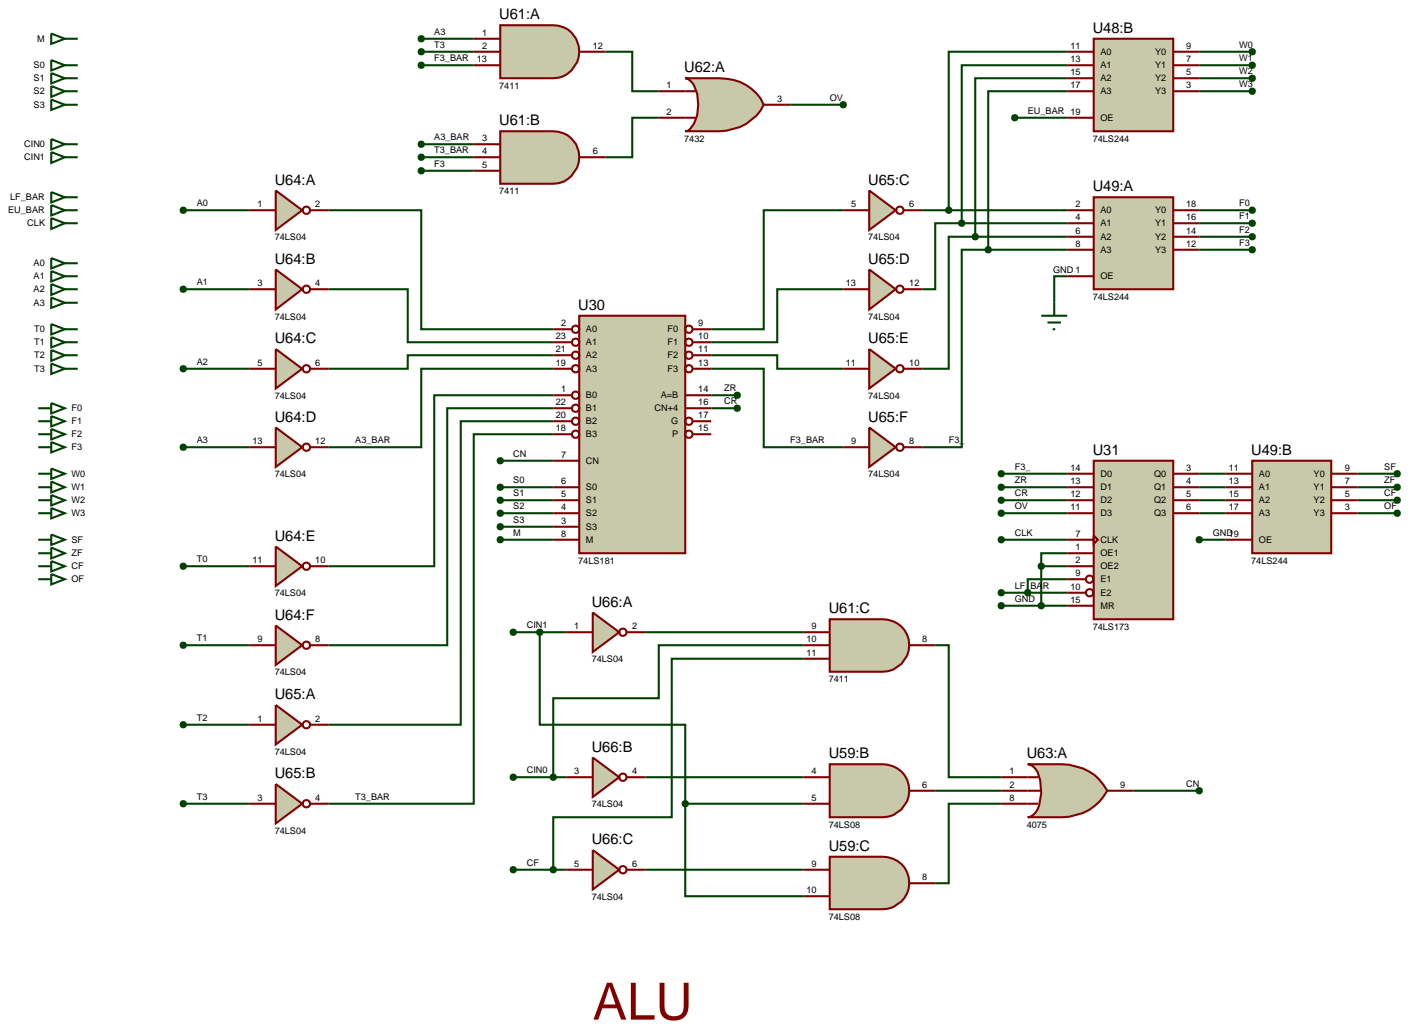
[picture p28: page 12]

A1 13
A2 15

GND 1

9 | E2 10 MR 15

U60
U58:E

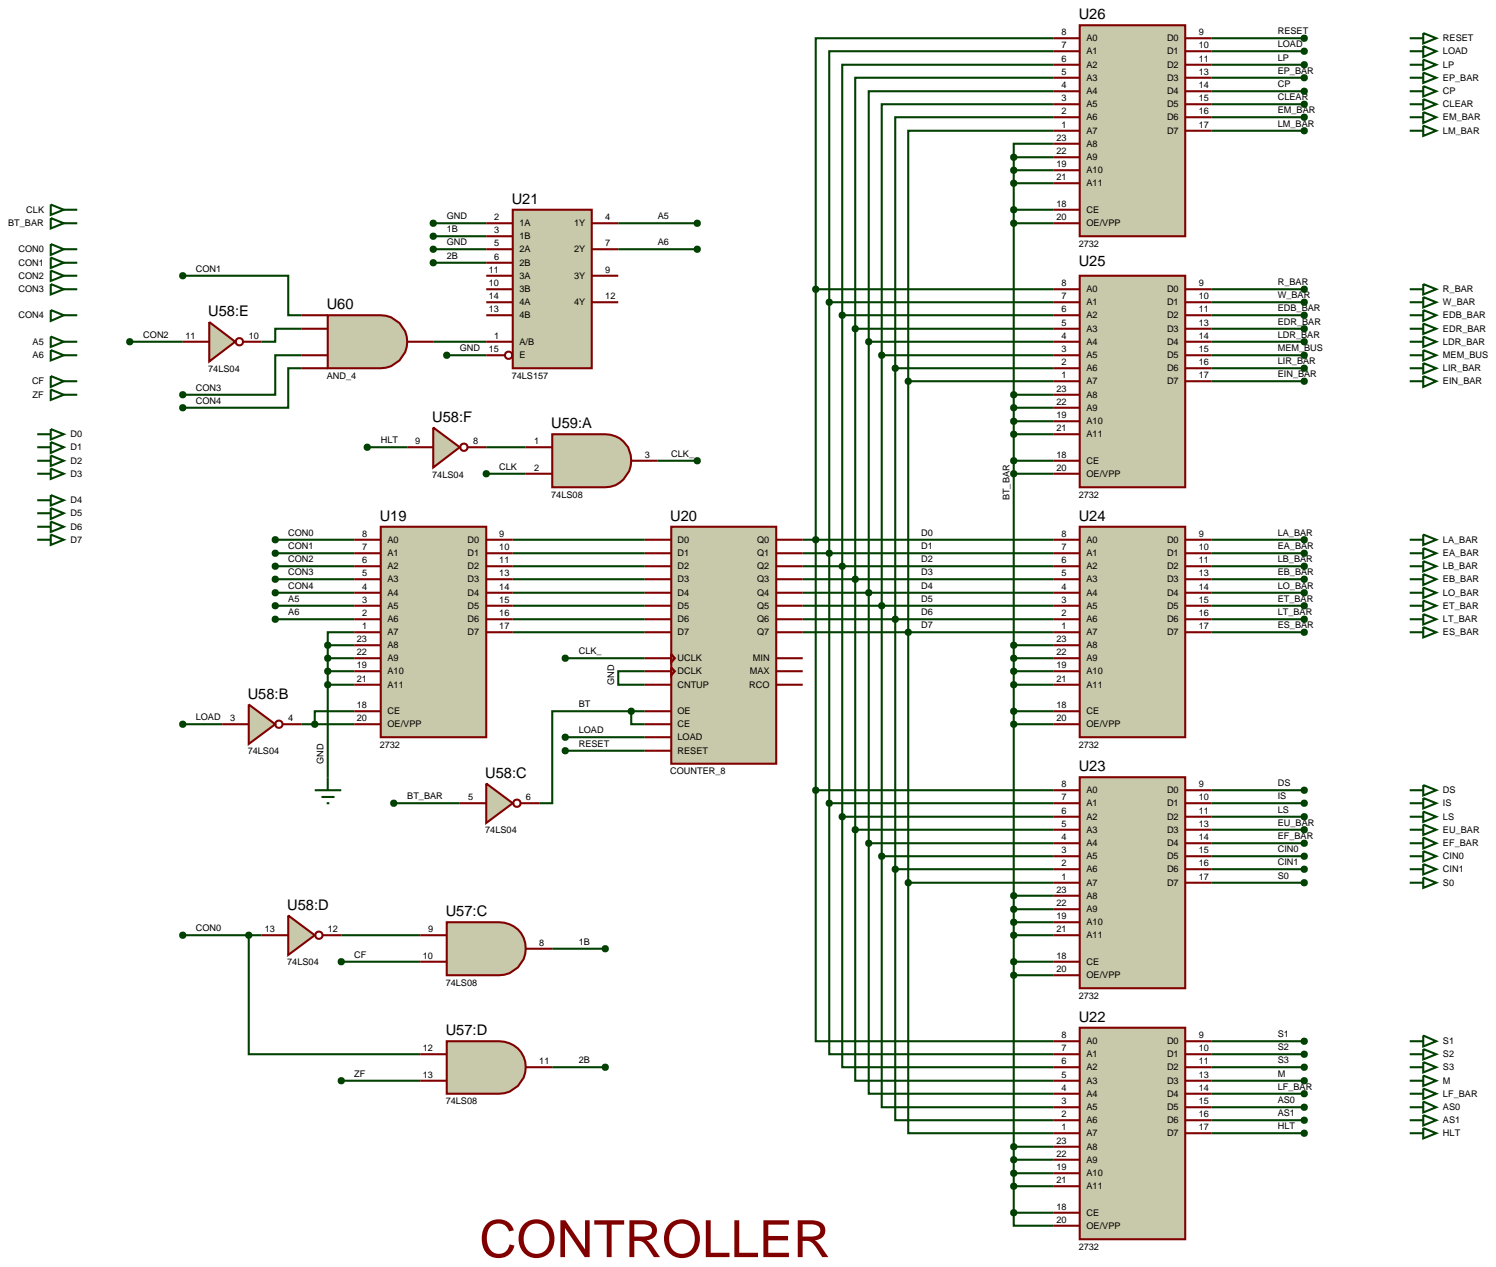
[picture p29: page 13]

U57:A

U5

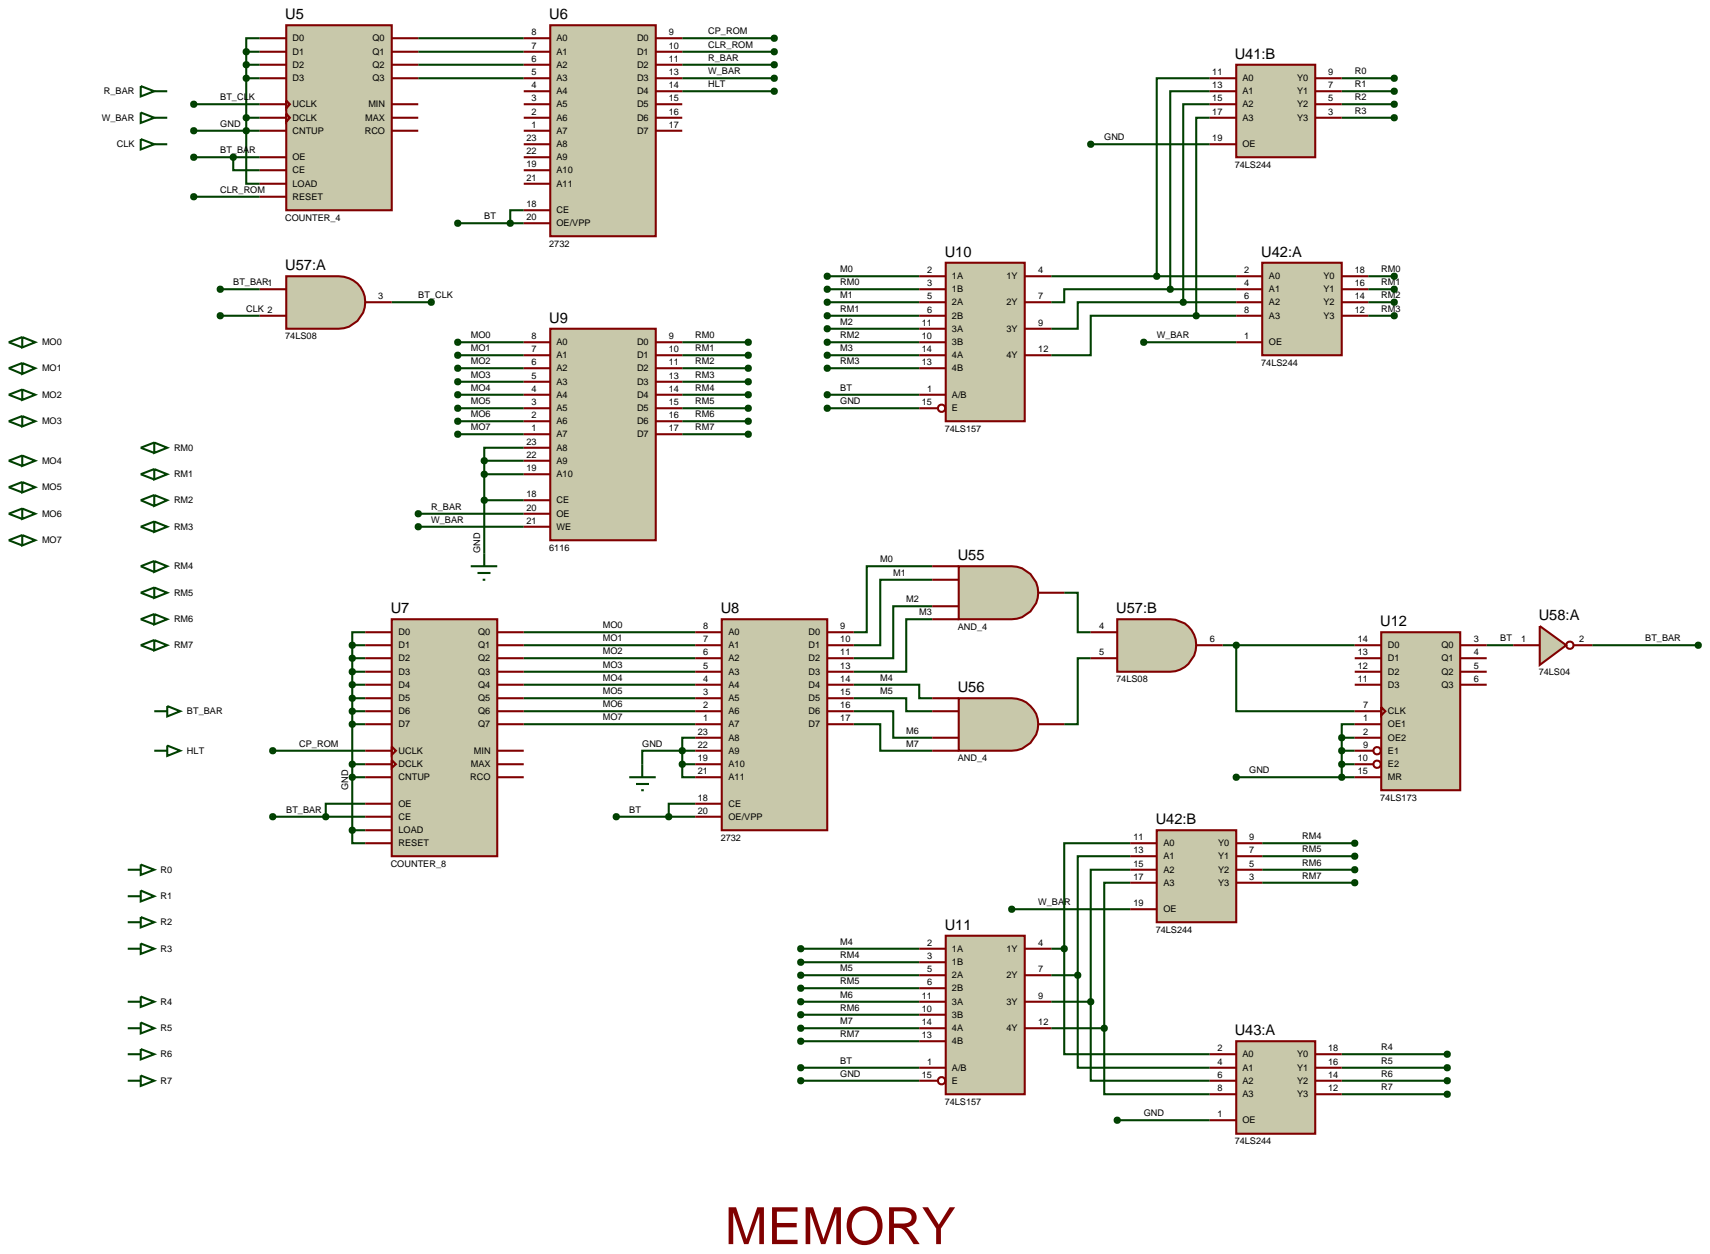
[picture p30: page 14]
