sauravguptadx/4-Bit-PC-Proteus/(list of files, drawings)

Other design files:
4-Bit PC/B2G5.pdsprj
